dakaneye/word-clock/docs/photos/arduino-rtc.jpg

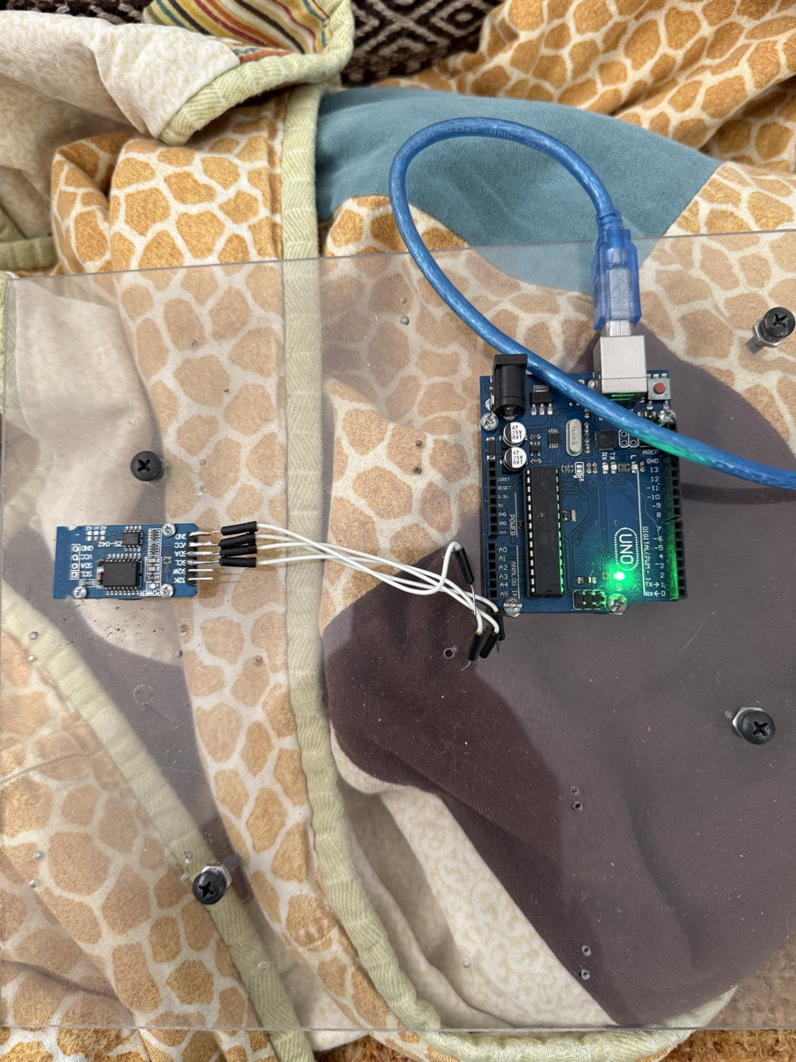
docs/photos/arduino-rtc.jpg
