dakaneye/word-clock/docs/photos/led-board-stripped.jpg

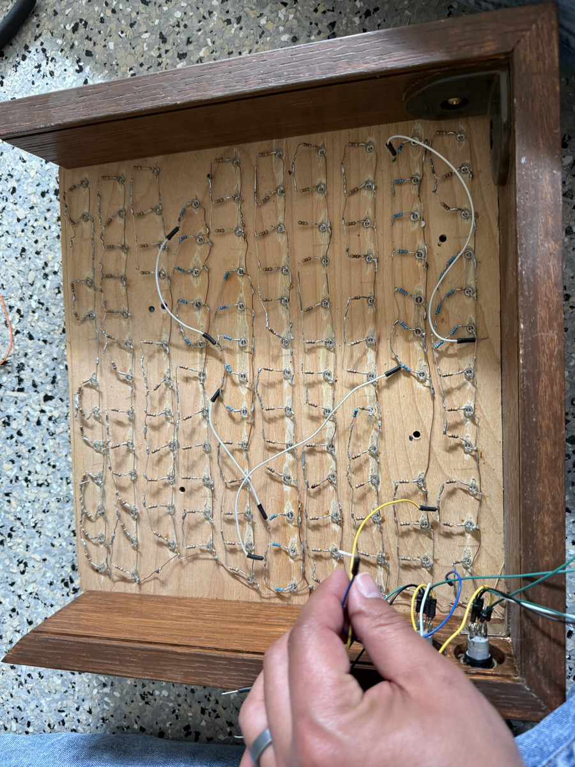
docs/photos/led-board-stripped.jpg
