dakaneye/word-clock/docs/photos/front-panel.jpg

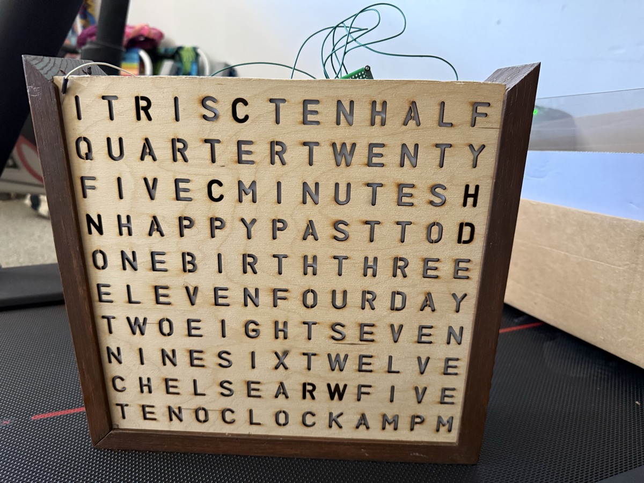
docs/photos/front-panel.jpg
