dakaneye/word-clock/(commit log)

2026-03-30 feat(docs): add design spec and blink test sketch
    Initial project setup with design spec covering hardware architecture
    (Mega + MOSFET modules), word grid mapping, pin assignments, time
    display logic, birthday mode, and testable software architecture.
    Includes blink test sketch to verify Arduino upload pipeline.
2026-03-30 fix(docs): correct word grid — BIRTH/THREE separate, DAY in row 6
    Row 5 is ONE BIRTH THREE (not BIRTHDAY). Birthday message
    displays as HAPPY BIRTH DAY CHELSEA using separate word groups.
    27 total word groups, not 28.
2026-03-30 docs: add design principles — simple, tested, maintainable
2026-03-30 fix(docs): align plan pin assignments with spec
    Config.h pin numbers now match spec's physical module grouping
    exactly. Test sketch pin arrays and button pins updated to match.
    No duplicate pins, all 28 outputs verified unique.
2026-03-30 feat: add config.h with word enum and pin assignments
2026-03-30 feat: add time_to_words with native macOS tests
    TDD-developed pure logic module. All 30 time-to-word mapping
    tests pass natively without Arduino hardware.
2026-03-30 feat: add display module for MOSFET pin control
2026-03-30 feat: add buttons module with debounce and hold-repeat
2026-03-30 feat: add birthday module — alternating display on May 4th
2026-03-30 feat: main sketch wiring all modules together
    Reads RTC, converts to words, handles buttons, applies birthday
    mode, and drives display. Serial debug output for monitoring.
2026-03-30 feat: add hardware test sketches for incremental validation
    rtc-test: verify DS3231 reads time
    pin-sweep: cycle each output to map words to pins
    word-test: serial command to light specific words
    button-test: verify button wiring
2026-03-30 docs: add reference photos of front panel, arduino, and LED board
2026-03-30 fix: address code review findings
    - Halt on RTC failure instead of continuing with garbage data
    - Add bounds check in displayShow() for word index
    - Move WORD_PINS array to config.cpp (extern in header) to avoid
    duplicate SRAM copies across translation units
    - Remove dead displayWordOff() function
    - Add boundary minute tests (:04/:05, :29/:30, :34/:35, :59)
    - Add AM/PM toggle test and birthday word set test (41 total)
    - Document pin 13 = onboard LED in config.cpp
    - Add explanatory comments in test sketches for why pin arrays
    are duplicated (Arduino IDE temp dir compilation breaks includes)
    [button-test.ino, config.cpp, config.h, display.cpp, display.h, pin-sweep.ino, test_time_to_words.cpp, word-clock.ino]
2026-03-30 docs: add step-by-step assembly guide
    10 phases from identifying word groups through final testing.
    Covers current board state, MOSFET module placement by zone,
    wiring tables, test commands, and troubleshooting.
2026-03-30 feat: public repo setup — CI, CodeQL, security scanning, docs
    - MIT license
    - CI workflow: native tests + Arduino compilation on push/PR
    - CodeQL analysis (C/C++) on push/PR + weekly schedule
    - Monthly Grype vulnerability scan
    - Dependabot for GitHub Actions
    - README with badges, build instructions, architecture overview
    - CONTRIBUTING.md with dev setup guide
    - Issue templates for bugs and feature requests
    - All GitHub Actions pinned to full commit SHAs
2026-03-30 feat: add customization guide and credit original reddit post
    - Restructure config.h with clearly marked customization section
    - Add W_NAME macro so birthday.cpp uses an indirection for the name
    - Customization guide covers name/birthday, front panel design,
    hardware alternatives, and power sizing
    - Credit the original reddit DIY post that inspired this project
    - Link customization guide from README
2026-04-08 fix(birthday): remove IT IS and AM/PM from birthday display phase
    The birthday phase should show only HAPPY BIRTH DAY CHELSEA, not
    IT IS HAPPY BIRTH DAY CHELSEA AM/PM. IT IS and AM/PM belong to
    the time display phase which alternates with the birthday message.
    Also updates the assembly guide with expanded wiring instructions,
    safety guidance, and troubleshooting section.
    [birthday.cpp, birthday.h]
2026-04-08 docs(assembly): add barrel jack breakout for 5V power supply
    The 5V 4A power supply has a barrel connector. The Arduino barrel
    jack expects 7-12V, so a breakout adapter is needed to expose bare
    +5V/GND wires for the LED bus and common ground.
2026-04-08 docs(assembly): single power supply for Arduino and LEDs
    Power Arduino via 5V pin from the same 5V supply that drives the
    LEDs. Eliminates the need for a separate USB power adapter. The 5V
    pin bypasses the barrel jack regulator and feeds the rail directly.
2026-04-08 docs(assembly): replace CR2032 method with 5V probe for cluster ID
    Coin cell can't reliably light white LEDs through the series
    resistors. Use the 5V supply through the inline fuse with a jumper
    wire as a probe instead — same topology the MOSFETs will use later.
2026-04-08 docs(assembly): mount and wire on plastic insert
    Adds Phase 2.5 (dry-fit layout + multimeter check for birthday word
    cathode wiring) and Phase 4.5 (build common ground bus before any
    module wiring). Rewrites Phase 3 to mount components on the existing
    plastic insert with M3 screws instead of vague back-panel guidance.
    New "Wiring technique" preamble at the start of Phase 4: color scheme
    (red=+5V, black=GND, yellow/white/green/blue for CH1/CH2/CH3/CH4),
    pre-cut/strip/tin batching, strain relief loops, bundle-by-module,
    and a single wire highway along the bottom edge.
    Moves the Arduino from bottom-right to bottom-left so the 1.5" button
    wires reach without splicing. Phase 5/7/8/10 updated to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
2026-04-09 docs: start build journal for future blog post
    Captures the planning session, the plastic insert architectural
    pivot, the birthday word daisy-chain discovery, and the first
    hands-on debugging day (6V supply surprise, finger-as-diagnostic,
    clip contact troubleshooting). Intended as raw material for a
    future blog post — kept as notes rather than polished prose.
2026-04-13 docs(journal): common cathode breakthrough and working clock
    Captures the debugging saga that led to discovering the board is
    common cathode (not common anode as documented), the cascade of
    simplification that eliminated MOSFET modules entirely in favor
    of direct Arduino pin drive, and the first successful time display.
    Key lesson: verify hardware assumptions before designing around
    them. "Common anode" was stated once and propagated through every
    document unchecked.
2026-04-14 feat: millis-based timekeeping, bypass broken DS3231
    The DS3231 RTC module's oscillator runs at 43% speed (50 RTC
    seconds per 117 real seconds, measured via serial diagnostics).
    The 11-year-old module's crystal has degraded beyond usability.
    Replace clock.cpp with millis()-based timekeeping using the
    Arduino Mega's 16MHz crystal (~±4 seconds/day drift). Time
    resets to midnight on power loss — set with buttons. Birthday
    mode disabled (no date tracking without RTC).
    Replacement DS3231 module ordered, arriving April 15. Will
    revert to RTC-based timekeeping when it arrives.
    Also adds seconds to ClockTime struct and diagnostic serial
    output (prints millis + time every second) for future deb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
    [clock.cpp, clock.h, word-clock.ino]
2026-04-14 refactor: common cathode + direct drive + collapse birthday words
    Update entire codebase to reflect actual hardware: common cathode
    LED board driven directly from Arduino Mega digital pins. No
    MOSFET modules, no external power supply, no shift registers.
    Code changes:
    - Collapse W_HAPPY/W_BIRTH/W_DAY/W_CHELSEA into single W_BIRTHDAY
    enum (physically daisy-chained as one anode wire on pin 11)
    - Remove W_NAME macro (birthday group is one unit)
    - WORD_PINS reduced from 28 to 25 entries
    - birthday.cpp uses W_BIRTHDAY instead of 4 separate words
    - Remove diagnostic serial output from word-clock.ino
    - Update all comments for common cathode + direct pin drive
    Doc changes:
    - Assembly guide rewri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
2026-04-14 fix(readme): remove stale MOSFET references
    Two lines still mentioned MOSFET modules — the project history
    blurb and the display module description in the architecture
    diagram. Updated to reflect direct pin drive.
2026-04-14 fix(time): flip AM/PM when crossing noon/midnight boundary
    The ':35-:59 past 11' cases say 'TO TWELVE [period]', but the period
    was being taken from the current hour rather than the approaching one.
    At 11:35 PM the clock said 'TWENTY FIVE MINUTES TO TWELVE PM' instead
    of 'TO TWELVE AM', and symmetrically at 11:35 AM. Flip isPM for the
    display word only when hour == 11 and we're in a 'TO next hour' block.
    [test_time_to_words.cpp, time_to_words.cpp]
2026-04-14 feat: restore RTC timekeeping with make set-time utility
    New DS3231 module arrived. Reverted clock.cpp to the RTC-based
    implementation (from aa61ed5), added clockSetEpoch() that passes a
    Unix epoch straight to RTClib's DateTime(uint32_t) constructor which
    expects Unix epoch and internally offsets to 2000.
    Added a serial time-sync path so we don't have to set with buttons:
    the sketch listens for 3s at boot for a 'T<unix_seconds>' line, and
    a new Makefile target 'set-time' uploads the firmware and then sends
    the host's local wall-clock time expressed as Unix epoch. scripts/
    set_time.sh holds the serial port open on one fd to avoid DTR resets
    during the listen window.
    [clock.cpp, clock.h, word-clock.ino]
2026-10-02 ci: fix CodeQL c-cpp analysis (#52)
    * ci: align codeql-action steps on v4.37.4
    CodeQL rejects an analyze step whose version differs from init.
    Dependabot bumped each step in a separate PR, which left them
    mismatched and failed every CodeQL run.
    * ci: analyze c-cpp without a build
    Autobuild finds no build system in the Arduino sketches, so CodeQL saw
    no C/C++ code and failed. Buildless extraction reads the sources
    directly.
