dakaneye/word-clock/(notices)

Notices in the files:
README.md:
License: MIT
